anujajoshi758/Good-Bad-Layout/README.md

# Good-Bad-Layout
[Report link](https://github.com/anujajoshi758/Good-Bad-Layout/blob/main/Board%202%20Report.pdf)
