anujajoshi758/Good-Bad-Layout/PCB_Board2.xlsx

Comment | Description | Designator | Footprint | LibRef | Quantity
22uF | 22uF ±10% 25V X5R 1206 Multilayer Ceramic Capacitors MLCC - SMD/SMT RoHS | C1, C2, C4, C5, C6 | 1206_Passive_Capacitor | C_22uF_1206 | 5
1uF | MULTILAYER CERAMIC CAPACITORS MLCC - SMD/SMT 1UF 50V 1206 ROHS | C3 | 1206_Passive_Capacitor | C_1uF_1206 | 1
Green | Green 513~528nm 1206 Light Emitting Diodes (LED) RoHS | LED1, LED3, LED4, LED5, LED6, LED7, LED8 | LED_1206 | LED_GREEN_1206 | 7
Blue | blue 1206 Light Emitting Diodes (LED) ROHS | LED2 | LED_1206 | LED_BLUE_1206 | 1
Power Jack | Power Barrel Connector Jack 2.10mm ID (0.083"), 5.50mm OD (0.217") Through Hole, Right Angle | P1 | Power_Jack | P_Power Jack | 1
AMS1117-3.3 | LOW DROPOUT REGULATORS(LDO) POSITIVE FIXED 1.3V @ 800MA 15V 3.3V 1A SOT-223 ROHS | PS1 | LDO | PS_AMS_LDO_3v3 | 1
1k | CHIP RESISTOR - SURFACE MOUNT 1KOHMS ±1% 1/4W 1206 ROHS | R1, R2, R3, R4 | 1206_Passive_Resitor | R_1K_1206 | 4
47 Ohms | 47Ω ±5% 0.25W ±200ppm/℃ 1206 Chip Resistor - Surface Mount RoHS | R5, R6, R7, R10, R11, R12 | 1206_Passive_Resitor | R_47Ohm_1206 | 6
10k | 10 kOhms ±5% 0.25W, 1/4W Chip Resistor 1206 (3216 Metric) Automotive AEC-Q200 Thick Film | R8, R9 | 1206_Passive_Resitor | R_10KOhm_1206 | 2
SW_2Pin_100mil_Switch | 2Pin Header | SW1, SW3, SW4, SW5, SW6 | 2Pin-Header-Conn | SW_2Pin_100mil_Switch | 5
PREC003SAAN-RC | Connector Header Through Hole 3 position 0.100" (2.54mm) | SW2 | 3_PIN_100mil | SW_3Pin_100mil_Switch | 1
TP_5V | Test Point 300 mil centers | TP1 | TP10x_Probe | TP_10x_Probe | 1
10x Probe TP | Test Point 300 mil centers | TP2, TP3, TP4, TP5, TP6, TP7, TP8, TP9, TP10, TP11 | TP10x_Probe | TP_10x_Probe | 10
LMC555CMX/NOPB | 555 Type, Timer/Oscillator _Single_ IC 3MHz 8-SO | U1 | TS555IDTTR | U_555_Fast | 1
SN74AHC14DR | Inverter IC 6 Channel Schmitt Trigger 14-SOIC | U2, U3 | HEX_74AC14 | U_74AHC14 | 2
