anujajoshi758/Good-Bad-Layout/(list of files, drawings)

Other design files:
PCB1_brd2.PcbDoc
PCB2_brd2.PcbDoc
PCB_Board2.PrjPcb
Sheet1.SchDoc
